VurtsGennadiy/TableClock/Photo/20230813_153638.jpg

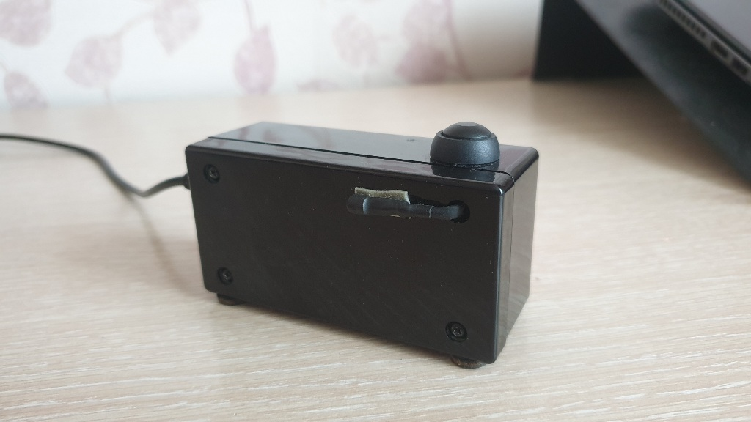
Photo/20230813_153638.jpg
