VurtsGennadiy/TableClock/Photo/20230813_153846.jpg

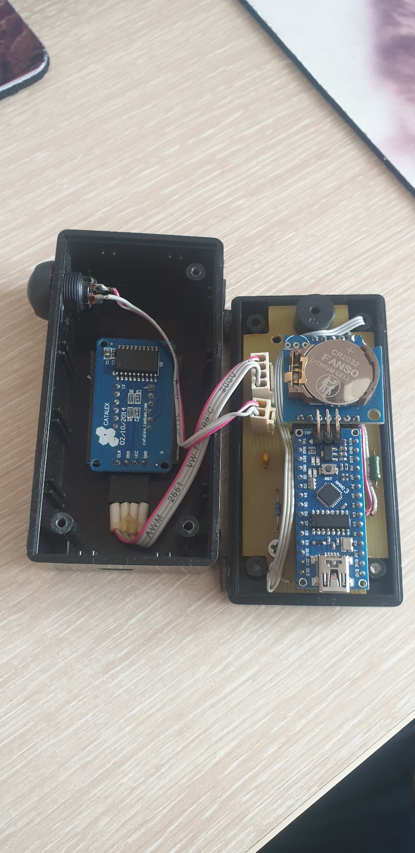
Photo/20230813_153846.jpg
