VurtsGennadiy/TableClock/PCB/Assembly.pdf

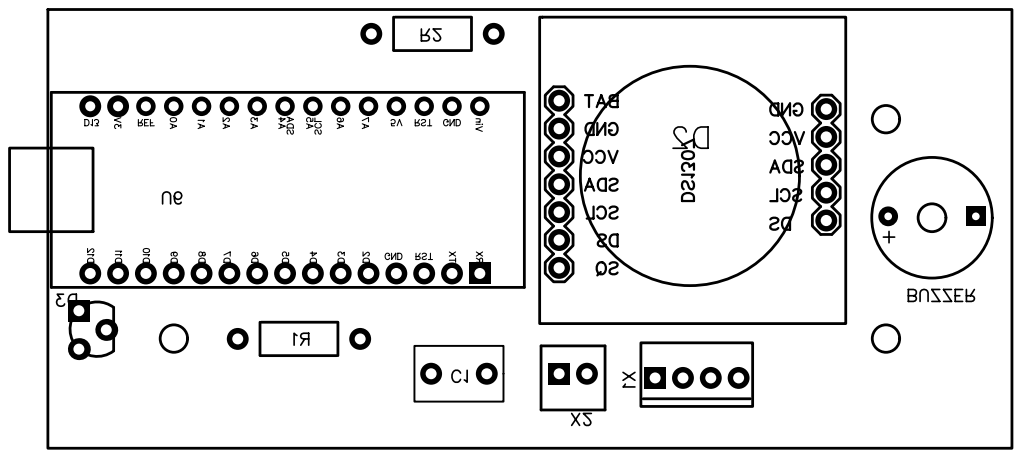
[picture p4: page 1]
