VurtsGennadiy/TableClock/PCB/Schematic.pdf

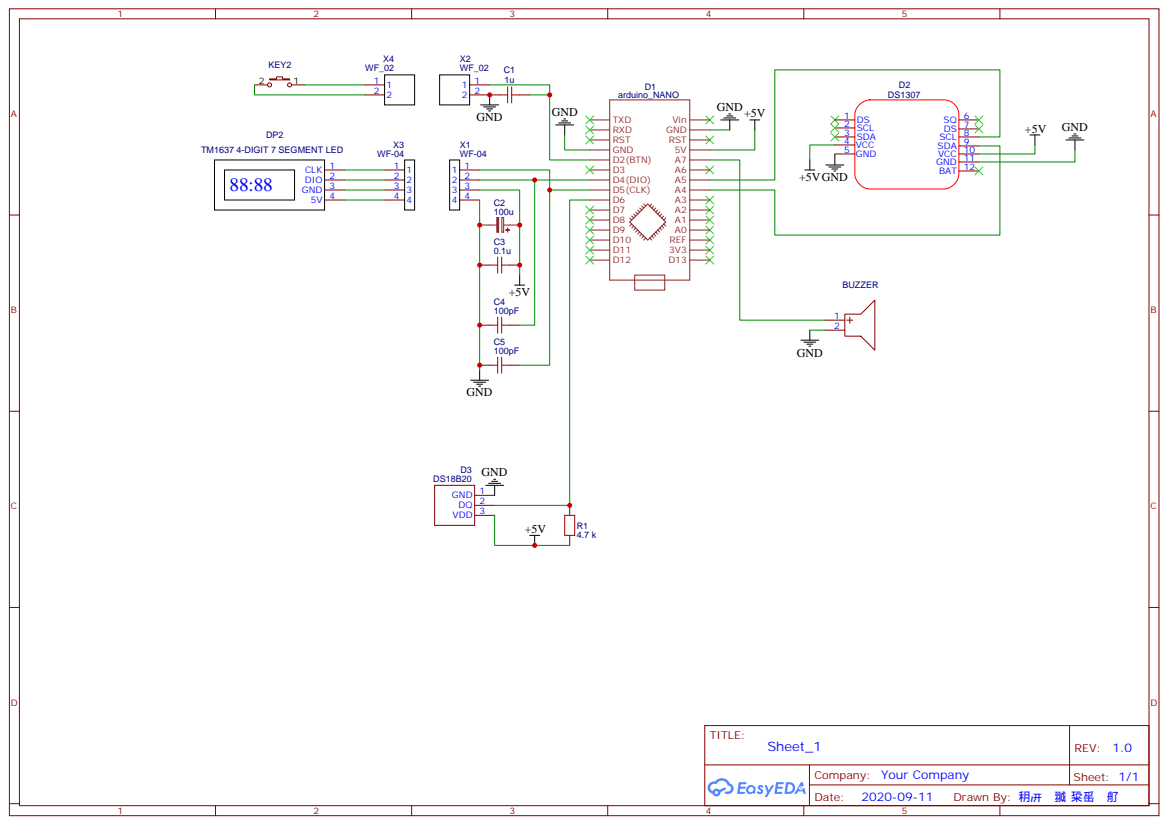
[picture p5: page 1]

Drawn By: 䄴㕃푀䎀 䊄䍃둌䑠
