VurtsGennadiy/TableClock/PCB/Bottom.pdf

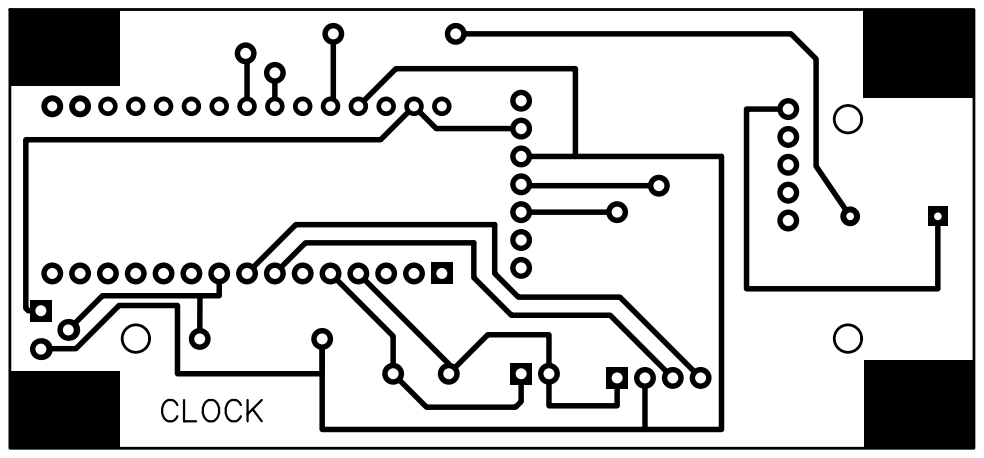
[picture p6: page 1]
