VurtsGennadiy/TableClock/PCB/Top.pdf

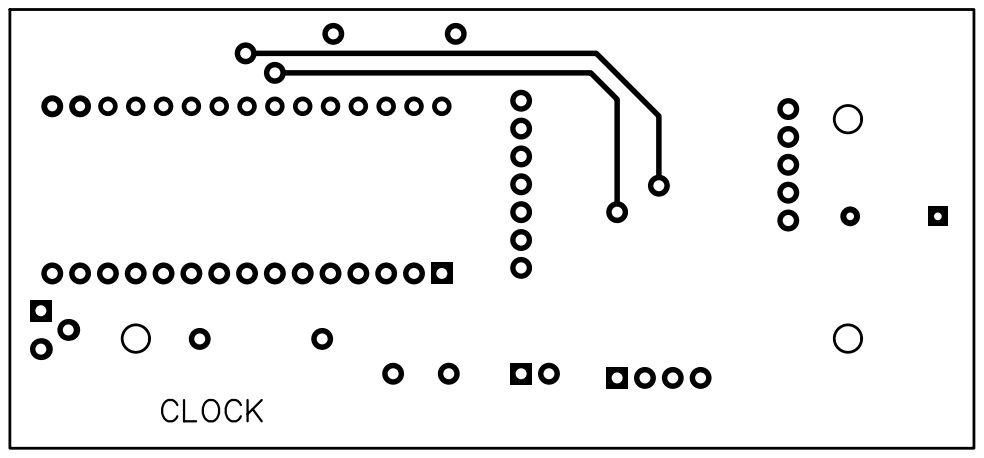
[picture p7: page 1]
