VurtsGennadiy/TableClock/(commit log)

2023-08-10 Подготовить проект к публикации
2023-08-10 Изменено название файла с кодом. Библиотеки OneWire и DateTime добавлены в zip архив для простоты установки
2023-08-10 Добавить файлы печатной платы
2023-08-13 Доработан будильник, реализовано моргание дисплея. Изменено подключение зумера на А0
2023-08-13 Отказался от замедления работы, для того чтобы дисплей работал стабильнее
2023-08-13 Добавлены фотографии
2023-08-13 Реализовать выбор мелодии будильника через константу ALARM_MELODY
2023-08-13 Добавить README.md
